nslewis/ME_588_Spring2022/Schematics and CAD/circuit_diagram.PNG

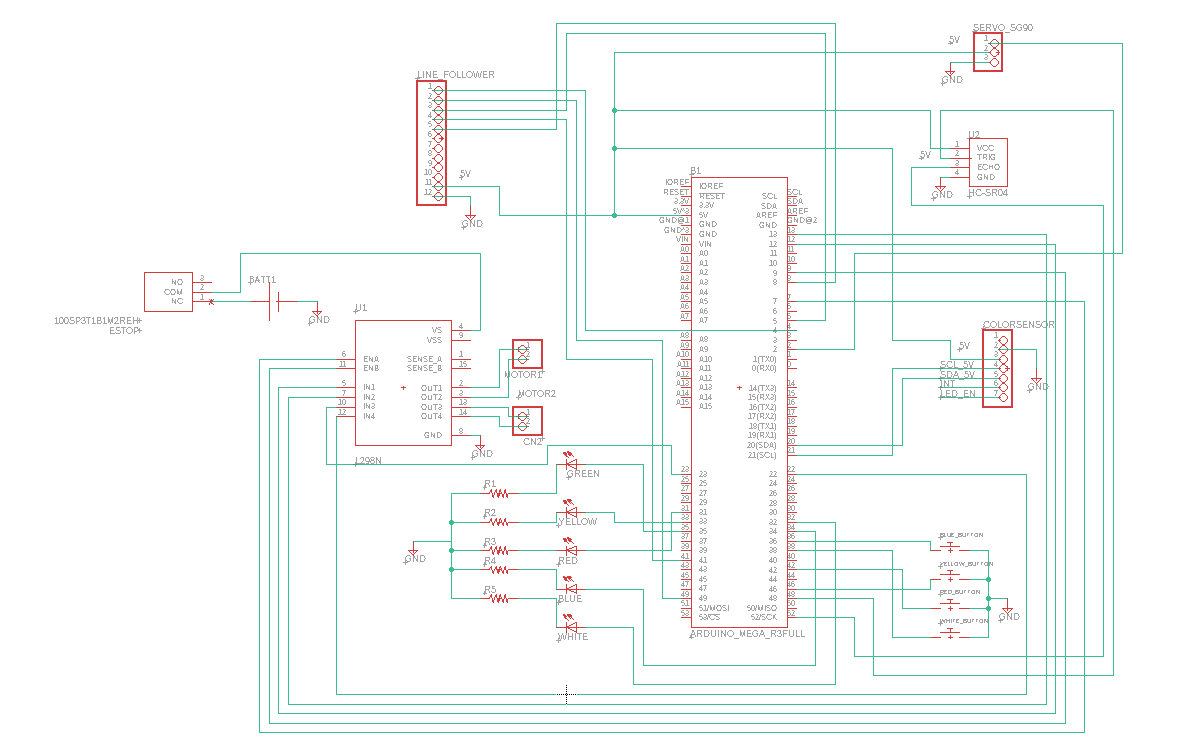
Schematics and CAD/circuit_diagram.PNG
