nslewis/ME_588_Spring2022/Schematics and CAD/Whacker.igs

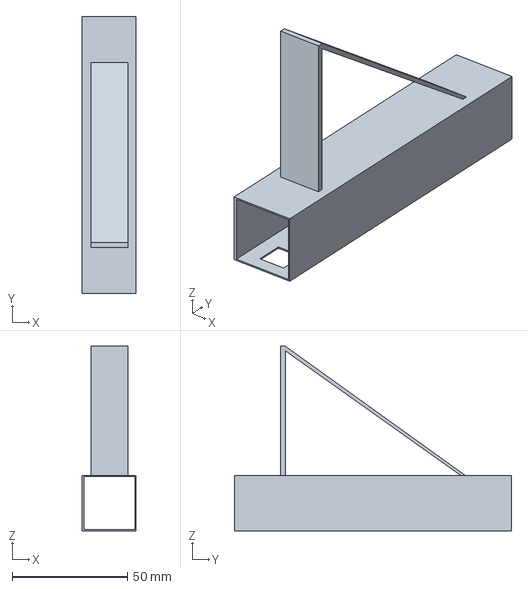
[picture p17: CAD file, 2022-05-02]
Schematics and CAD/Whacker.igs
23.5 x 120.0 x 80.0 mm
