nslewis/ME_588_Spring2022/Schematics and CAD/Stand.igs

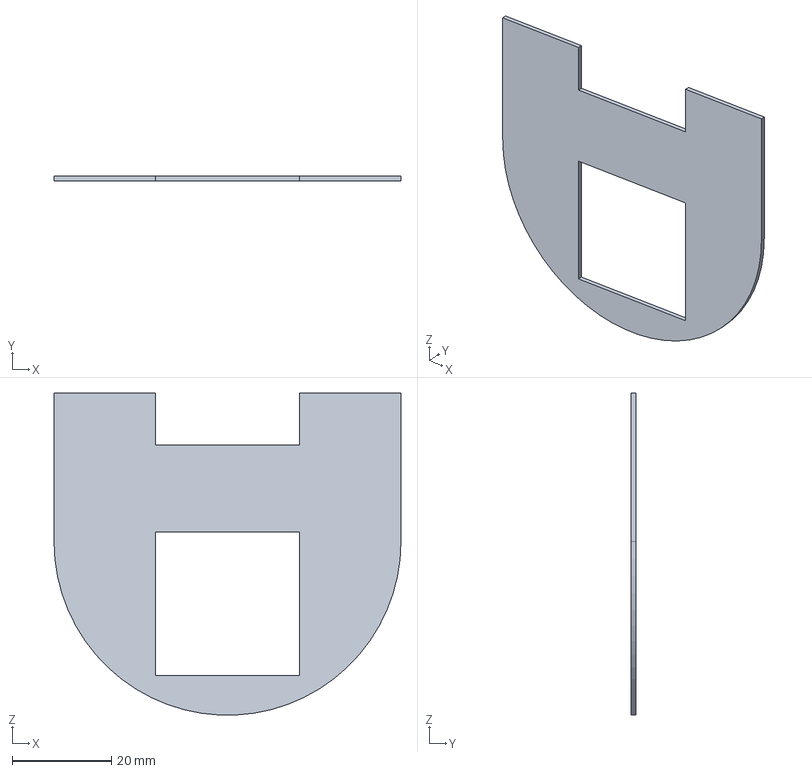
[picture p18: CAD file, 2022-05-02]
Schematics and CAD/Stand.igs
70.0 x 1.00 x 65.0 mm
