nslewis/ME_588_Spring2022/(list of files, cad)

Other CAD files:
Schematics and CAD/Whacker.CATPart
Schematics and CAD/stand.CATPart
