nslewis/ME_588_Spring2022/Schematics and CAD/ME588_FinalProject_Team6_Schematics.sch

## EAGLE design Schematics and CAD/ME588_FinalProject_Team6_Schematics.sch (2022-05-02)

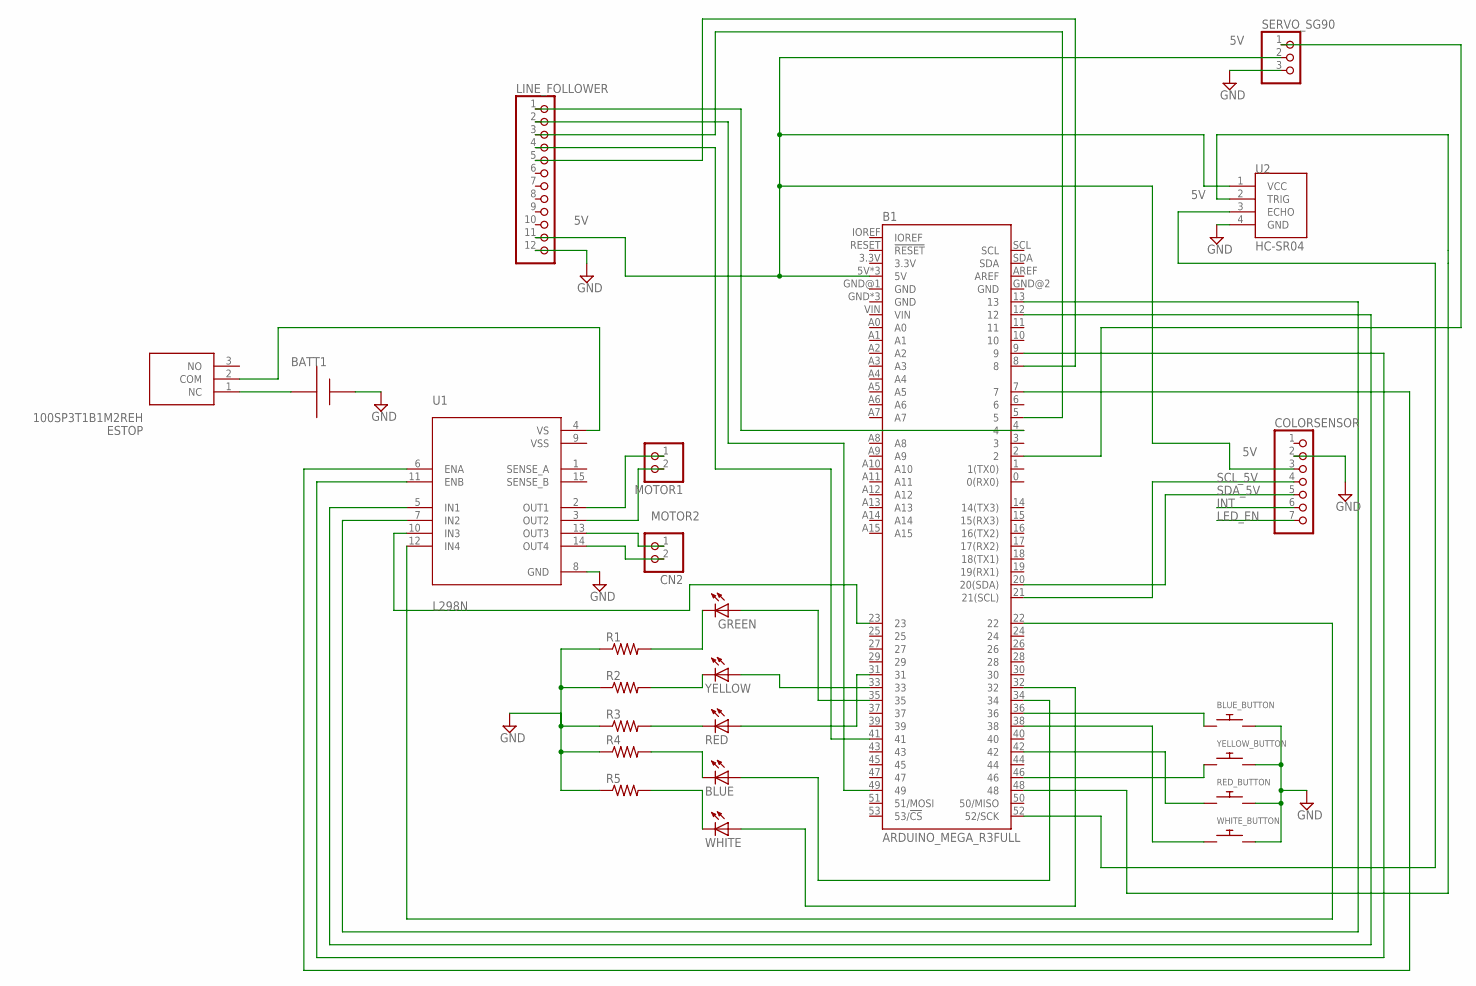
[picture p19: schematic ME588_FinalProject_Team6_Schematics.sch]

Parts:
B1: ARDUINO_MEGA_R3FULL; ARDUINO_MEGA_NO_SILK
BATT1: AAA; 12BH412
BLUE: LED5MM
BLUE_BUTTON: SWITCH_PUSHBUTTONC&K_KSS; BTN_CK_KSS
CN2: JST_2PIN-SMT-RA; JST-PH-2-SMT-RA
COLORSENSOR: HEADER-1X770MIL; 1X07_ROUND_70
ESTOP: 100SP3T1B1M2REH
GREEN: LED5MM
LINE_FOLLOWER: PINHD-1X12; 1X12
MOTOR1: JST_2PIN-SMT-RA; JST-PH-2-SMT-RA
R1, R2, R3, R4, R5: R-US_0204/2V; 0204V
RED: LED5MM
RED_BUTTON: SWITCH_PUSHBUTTONC&K_KSS; BTN_CK_KSS
SERVO_SG90: PINHD-1X3CB; 1X03-CLEANBIG
U1: L298N; TO127P2020X500X2100-15
U2: HC-SR04; XCVR_HC-SR04
WHITE: LED5MM
WHITE_BUTTON: SWITCH_PUSHBUTTONC&K_KSS; BTN_CK_KSS
YELLOW: LED5MM
YELLOW_BUTTON: SWITCH_PUSHBUTTONC&K_KSS; BTN_CK_KSS

Connections:
5V: B1.5V, COLORSENSOR.3, LINE_FOLLOWER.11, SERVO_SG90.2, U2.1 (VCC)
GND: BATT1.+, BLUE_BUTTON.P$2, COLORSENSOR.2, LINE_FOLLOWER.12, R1.1, R2.1, R3.1, R4.1, R5.1, RED_BUTTON.P$2, SERVO_SG90.3, U1.8 (GND), U2.4 (GND), WHITE_BUTTON.P$2, YELLOW_BUTTON.P$2
INT: COLORSENSOR.6
LED_EN: COLORSENSOR.7
MOTOR2: CN2.1 (2), U1.13 (OUT3)
unnamed: GREEN.K (C), R1.2
unnamed: R2.2, YELLOW.K (C)
unnamed: R3.2, RED.K (C)
unnamed: BLUE.K (C), R4.2
unnamed: R5.2, WHITE.K (C)
unnamed: B1.35, GREEN.A
unnamed: B1.33, YELLOW.A
unnamed: B1.31, RED.A
unnamed: B1.34, BLUE.A
unnamed: B1.32, WHITE.A
unnamed: B1.36, BLUE_BUTTON.P$1
unnamed: B1.46, YELLOW_BUTTON.P$1
unnamed: B1.42, RED_BUTTON.P$1
unnamed: BATT1.-, ESTOP.1 (NC)
unnamed: B1.38, WHITE_BUTTON.P$1
unnamed: MOTOR1.1 (2), U1.2 (OUT1)
unnamed: ESTOP.2 (COM), U1.4 (VS)
unnamed: MOTOR1.2 (1), U1.3 (OUT2)
unnamed: B1.7, U1.6 (ENA)
unnamed: CN2.2 (1), U1.14 (OUT4)
unnamed: B1.9, U1.11 (ENB)
unnamed: B1.12, U1.5 (IN1)
unnamed: B1.13, U1.7 (IN2)
unnamed: B1.23, U1.10 (IN3)
unnamed: B1.22, U1.12 (IN4)
unnamed: B1.48, U2.2 (TRIG)
unnamed: B1.2, SERVO_SG90.1
unnamed: B1.52 (52/SCK), U2.3 (ECHO)
unnamed: B1.4, LINE_FOLLOWER.1
unnamed: B1.49, LINE_FOLLOWER.2
unnamed: B1.5, LINE_FOLLOWER.3
unnamed: B1.8, LINE_FOLLOWER.5
unnamed: B1.41, LINE_FOLLOWER.4
SCL_5V: B1.21 (21(SCL)), COLORSENSOR.4
SDA_5V: B1.20 (20(SDA)), COLORSENSOR.5
