nslewis/ME_588_Spring2022/(commit log)

2022-04-21 Added Line Testing with Ultrasonic
2022-05-02 Added Schematics and CAD
    [ME588_FinalProject_Team6_Schematics.sch, Stand.igs, Whacker.CATPart, Whacker.igs, stand.CATPart]
